jbolbach/A8_SKR14/Images/PS_LCD_FRONT.jpg

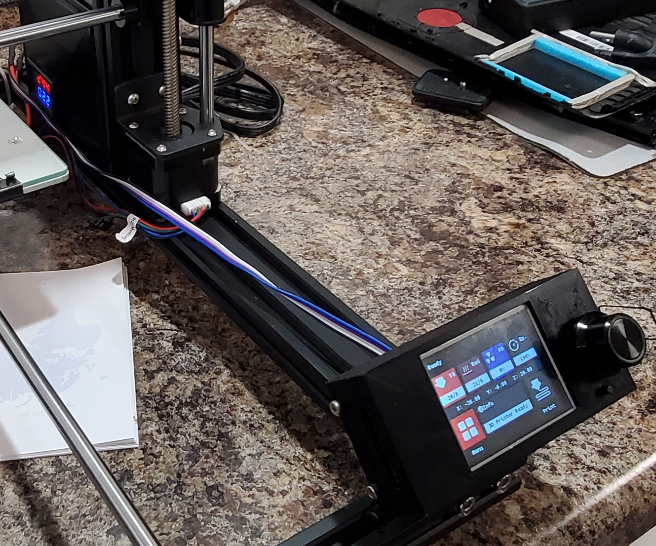
Images/PS_LCD_FRONT.jpg
