jbolbach/A8_SKR14/Images/Control_Back.jpg

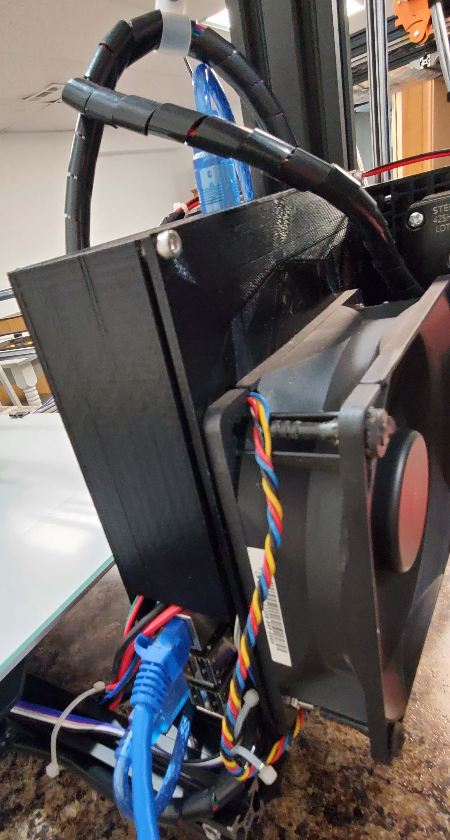
Images/Control_Back.jpg
