jbolbach/A8_SKR14/Images/Control_Inside.jpg

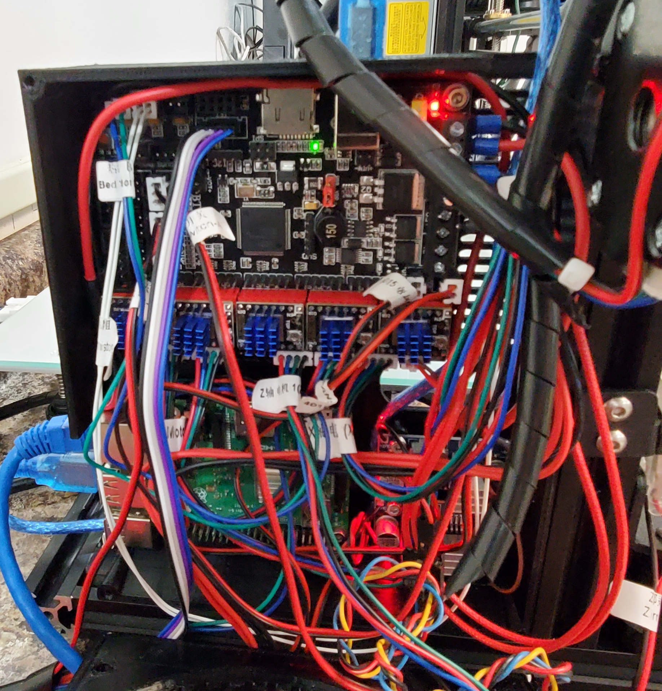
Images/Control_Inside.jpg
