jbolbach/A8_SKR14/Images/Control_LCD.jpg

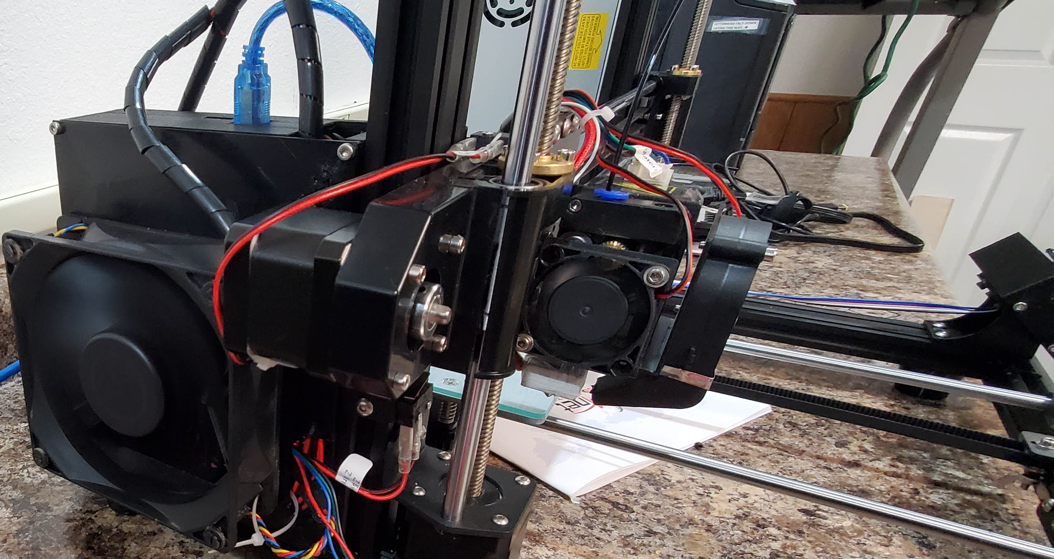
Images/Control_LCD.jpg
