jbolbach/A8_SKR14/Images/E3DV6_Upgrade_R01.png

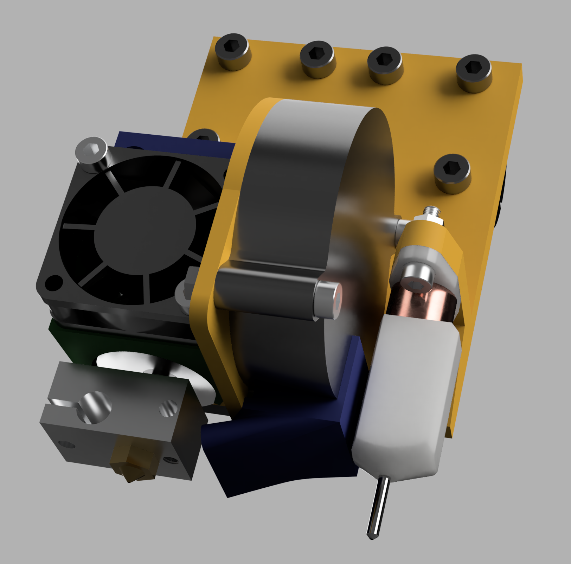
Images/E3DV6_Upgrade_R01.png
