jbolbach/A8_SKR14/Images/PS_Back.jpg

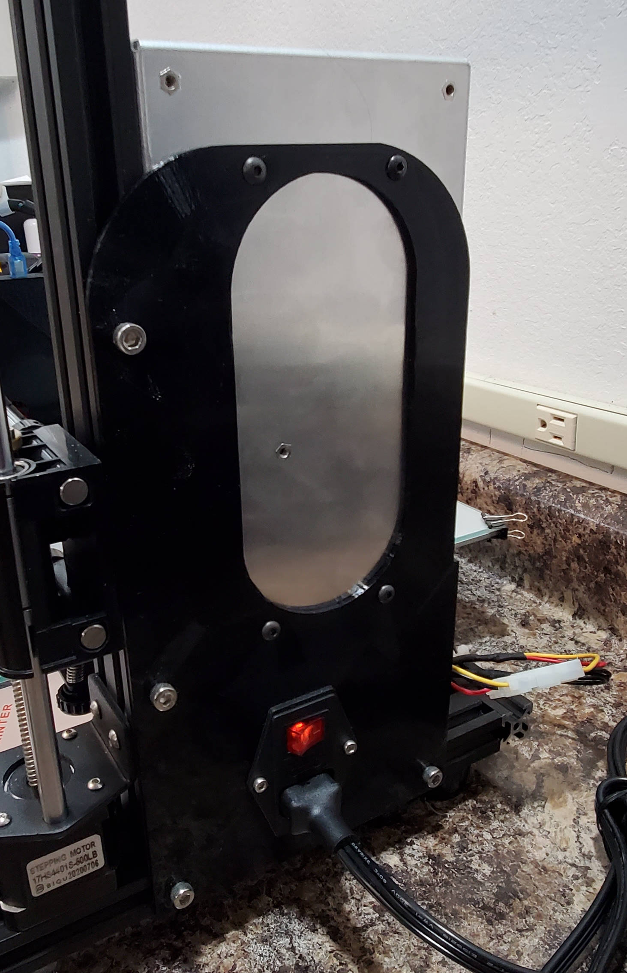
Images/PS_Back.jpg
