jbolbach/A8_SKR14/Images/Render_View.jpg

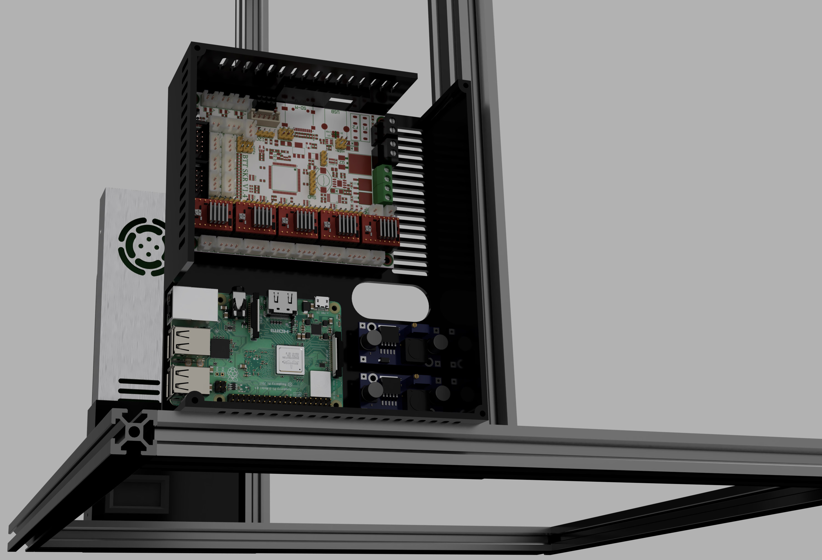
Images/Render_View.jpg
