jbolbach/A8_SKR14/Images/Render_View.PNG

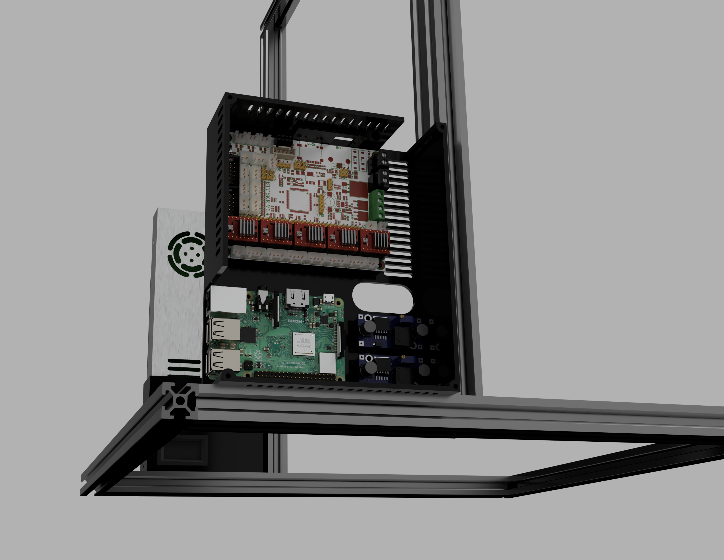
Images/Render_View.PNG
