jbolbach/A8_SKR14/STL/PS_Cover.stl

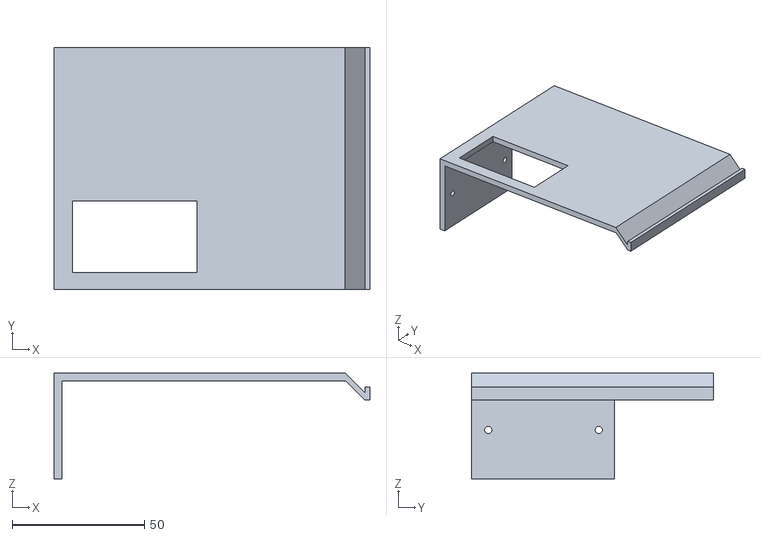
[picture p9: CAD file, 2021-04-16]
STL/PS_Cover.stl
119.4 x 91.6 x 40.0
