jbolbach/A8_SKR14/STL/TFT_Front.stl

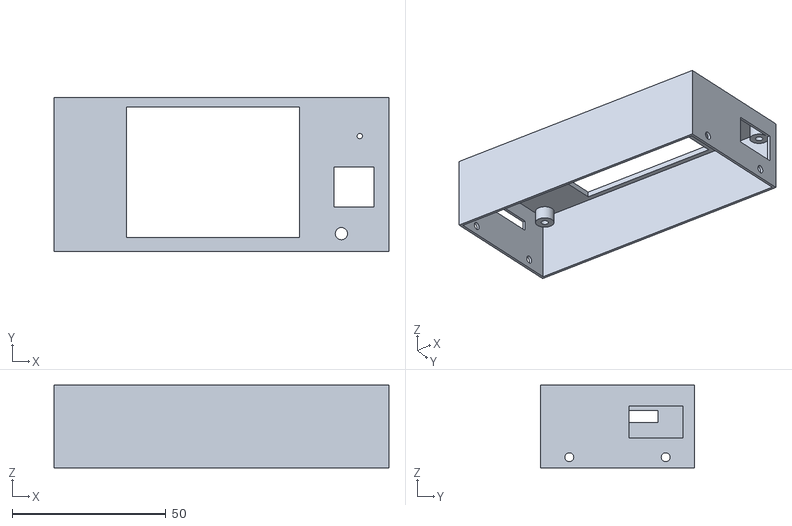
[picture p10: CAD file, 2021-04-16]
STL/TFT_Front.stl
109.0 x 50.0 x 27.0
