jbolbach/A8_SKR14/STL/Controller_Case.stl

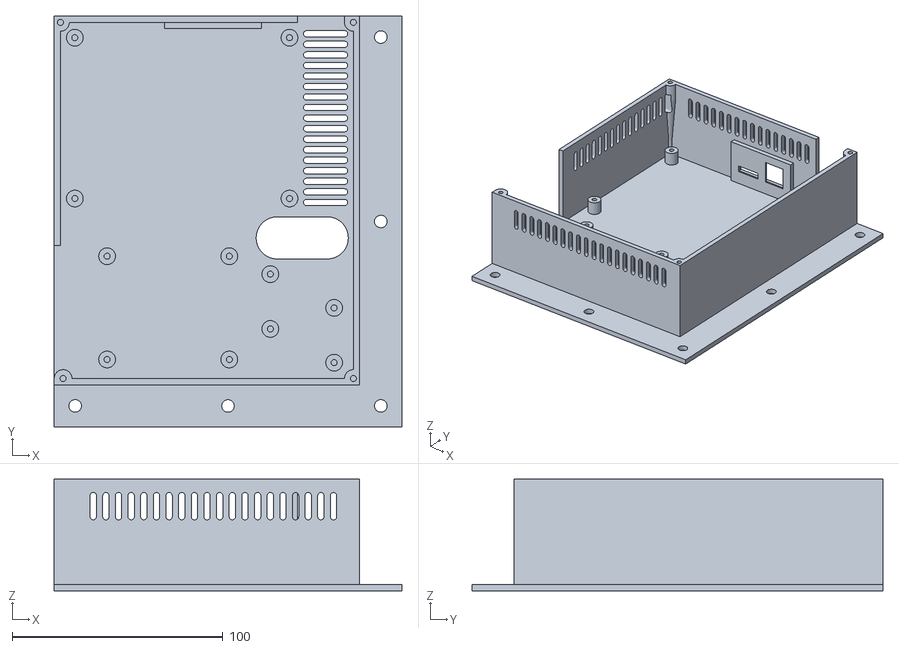
[picture p11: CAD file, 2021-04-16]
STL/Controller_Case.stl
165.0 x 195.0 x 53.0
