jbolbach/A8_SKR14/STL/TFT_Mount.stl

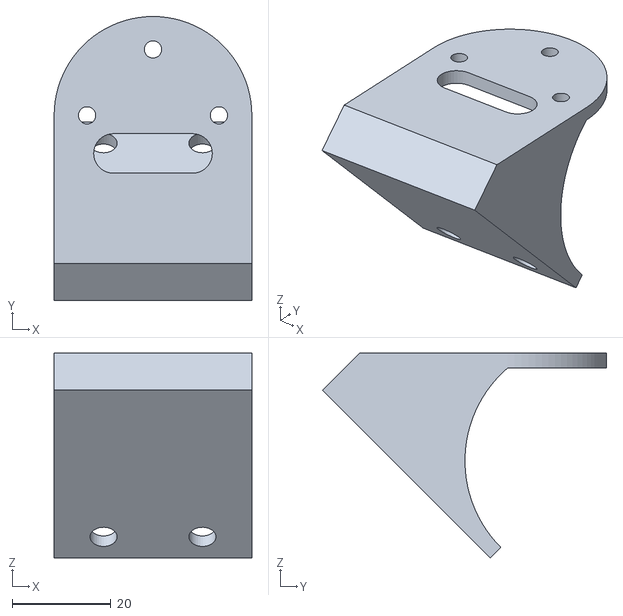
[picture p12: CAD file, 2021-04-16]
STL/TFT_Mount.stl
40.0 x 57.4 x 41.4
