jbolbach/A8_SKR14/STL/Controller_Lid.stl

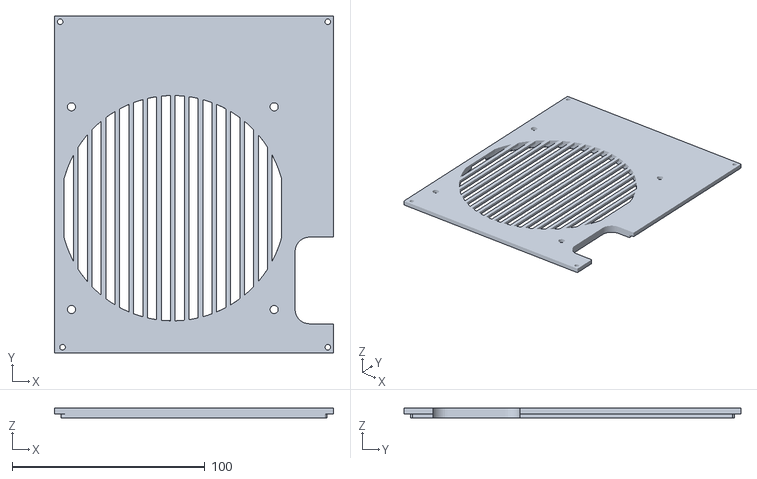
[picture p13: CAD file, 2021-04-16]
STL/Controller_Lid.stl
145.0 x 175.0 x 5.00
