jbolbach/A8_SKR14/STL/PS_Case.stl

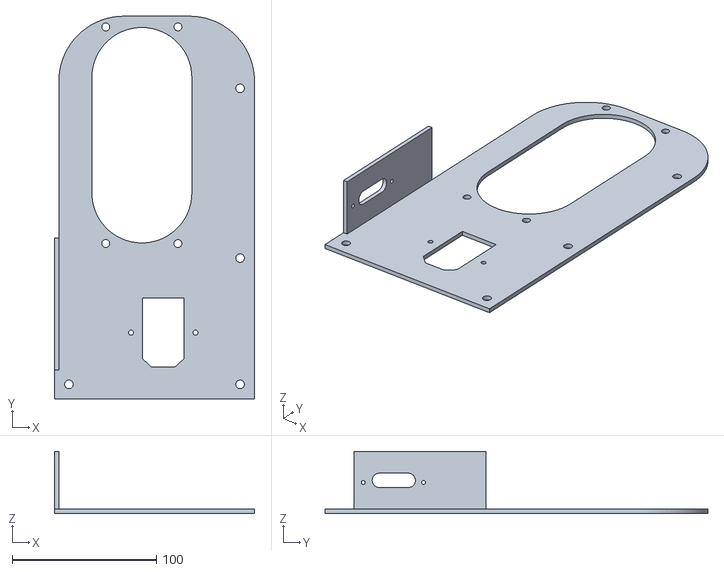
[picture p14: CAD file, 2021-04-16]
STL/PS_Case.stl
138.5 x 265.0 x 43.0
