jbolbach/A8_SKR14/STL/TFT_Back.stl

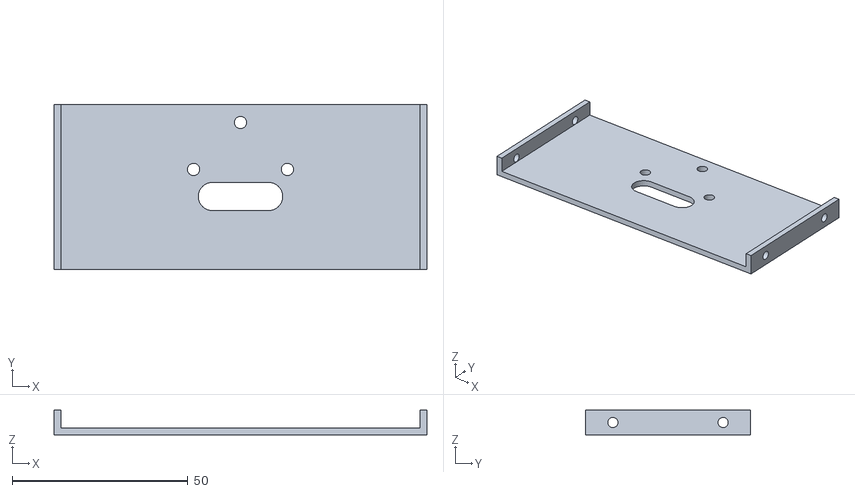
[picture p15: CAD file, 2021-04-16]
STL/TFT_Back.stl
106.0 x 47.0 x 7.00
