jbolbach/A8_SKR14/Marlin-2.0.x-A8+/Marlin/Configurations_With_Touch/Configuration_adv.h

#define E0_AUTO_FAN_PIN -1
#define E1_AUTO_FAN_PIN -1
#define E2_AUTO_FAN_PIN -1
#define E3_AUTO_FAN_PIN -1
#define E4_AUTO_FAN_PIN -1
#define E5_AUTO_FAN_PIN -1
#define E6_AUTO_FAN_PIN -1
#define E7_AUTO_FAN_PIN -1
#define CHAMBER_AUTO_FAN_PIN -1
#define HOMING_BUMP_MM      { 5, 5, 2 }       // (mm) Backoff from endstops after first bump
#define HOMING_BUMP_DIVISOR { 2, 2, 4 }       // Re-Bump Speed Divisor (Divides the Homing Feedrate)
  #define HOME_AFTER_G34
#define MICROSTEP_MODES { 16, 16, 16, 16, 16, 16 } // [1,2,4,8,16]
    #define X_CURRENT       800        // (mA) RMS current. Multiply by 1.414 for peak current.
    #define X_CURRENT_HOME  X_CURRENT  // (mA) RMS current for sensorless homing
    #define X_MICROSTEPS     32    // 0..256
    #define Y_CURRENT       800
    #define Y_CURRENT_HOME  Y_CURRENT
    #define Y_MICROSTEPS     32
    #define Z_CURRENT       800
    #define Z_CURRENT_HOME  Z_CURRENT
    #define Z_MICROSTEPS     32
    #define Z2_CURRENT      800
    #define Z2_CURRENT_HOME Z2_CURRENT
    #define Z2_MICROSTEPS    32
    #define E0_CURRENT      800
    #define E0_MICROSTEPS    32
  #define X_HYBRID_THRESHOLD     100  // [mm/s]
  #define X2_HYBRID_THRESHOLD    100
  #define Y_HYBRID_THRESHOLD     100
  #define Y2_HYBRID_THRESHOLD    100
  #define Z_HYBRID_THRESHOLD       3
  #define Z2_HYBRID_THRESHOLD      3
  #define Z3_HYBRID_THRESHOLD      3
  #define Z4_HYBRID_THRESHOLD      3
  #define E0_HYBRID_THRESHOLD     30
  #define E1_HYBRID_THRESHOLD     30
  #define E2_HYBRID_THRESHOLD     30
  #define E3_HYBRID_THRESHOLD     30
  #define E4_HYBRID_THRESHOLD     30
  #define E5_HYBRID_THRESHOLD     30
  #define E6_HYBRID_THRESHOLD     30
  #define E7_HYBRID_THRESHOLD     30
