jbolbach/A8_SKR14/(commit log)

2021-04-16 Initial Upload
    [Configuration.h, Configuration_adv.h, Controller_Case.stl, Controller_Lid.stl, PS_Case.stl, PS_Cover.stl, TFT_Back.stl, TFT_Front.stl]
2021-04-18 Updated HotEnd PID Max Current, re-tuned Kp Ki Kd
    [Configuration.h]
2021-11-28 S-Curve Accel
    [Configuration.h, Configuration_adv.h]
2021-12-07 BabyStepping Adjustment
    [Configuration_adv.h]
2022-05-28 New Extruder Pics
